planetmbit/KiCAD_LoadSW_OCP_Circuit_v1_2/README.md

# KiCAD_LoadSW_OCP_Circuit_v1_2
This is Over Current Protection & Load Switch(w/ Current Sense) Circuit's KiCAD Repository (This belongs to the author and The Ryman Sat Project.)
