planetmbit/KiCAD_LoadSW_OCP_Circuit_v1_2/FusionPCB_Files/BOM_r02.xlsx

Designator | MPN/Seeed SKU | Qty | Link
C1 C2 C3 C4 C5 C6 C7 C8 C9 C10 C11 C12 C13 C14 C15 C16 C17 C18 C19 C20 C21 C22 C23 C24 C25 C26 | VJ0603Y104KXXAC | 26 | https://www.digikey.com/en/products/detail/vishay-vitramon/VJ0603Y104KXXAC/2345170
Q1 Q4 Q7 Q10 Q13 Q16 Q19 Q22 | SISS23DN-T1-GE3 | 8 | http://www.vishay.com/docs/62852/siss23dn.pdf
R24 R35 R46 R57 R72 R83 | RK73H1JTTD1004F | 6 | https://www.digikey.jp/product-detail/ja/koa-speer-electronics-inc/RK73H1JTTD1004F/2019-RK73H1JTTD1004FCT-ND/9846893
R25 R28 R29 R36 R39 R40 R47 R50 R51 R58 R61 R62 R65 R66 R73 R76 R77 R84 R87 R88 R91 R92 | RK73H1JTTD1002F | 22 | https://www.digikey.jp/product-detail/ja/koa-speer-electronics-inc/RK73H1JTTD1002F/2019-RK73H1JTTD1002FTR-ND/9844954
R26 R37 R48 R59 R74 R85 R118 R119 R120 R121 R123 | RK73B1JTTD102J | 11 | https://www.digikey.jp/product-detail/ja/koa-speer-electronics-inc/RK73B1JTTD102J/2019-RK73B1JTTD102JTR-ND/9844698
R1 R2 R3 R4 R5 R6 R7 R8 R9 R10 R11 R12 R13 R14 R15 R16 R17 R18 R19 R94 R95 R97 R98 R100 R101 R103 R104 R106 R107 R109 R110 R112 R113 R115 R116 | RK73Z1JTTD | 35 | https://www.digikey.jp/product-detail/ja/koa-speer-electronics-inc/RK73Z1JTTD/2019-RK73Z1JTTDTR-ND/9845478
Rh1 Rh2 Rh3 Rh4 Rh5 Rh6 R21 R27 R30 R32 R38 R41 R43 R49 R52 R54 R60 R63 R64 R67 R69 R75 R78 R80 R86 R89 R90 R93 | RK73B1JTTD104J | 28 | https://www.digikey.jp/product-detail/ja/koa-speer-electronics-inc/RK73B1JTTD104J/2019-RK73B1JTTD104JTR-ND/9844700
