planetmbit/KiCAD_LoadSW_OCP_Circuit_v1_2/Assembly/AssemblyDrawing.pdf

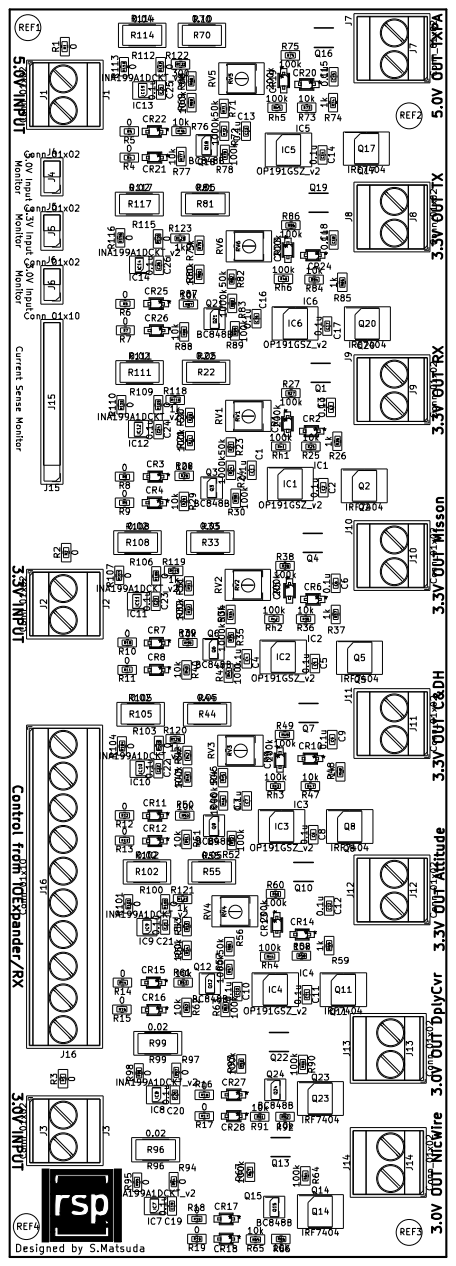
[picture p18: page 1]
