planetmbit/KiCAD_LoadSW_OCP_Circuit_v1_2/(commit log)

2020-12-06 Changed Design plan(Module Design)
    [rsp02_LoadSW_OCP_Circuit_v1_2.sch, rsp02_module_CS.sch, rsp02_module_LoadSW_OCP_3_3V.sch, rsp02_module_LoadSW_OCP_5_0V.sch, rsp02_module_LoadSW_noOCP.sch]
2020-12-07 Update Design
    [rsp02_LoadSW_OCP_Circuit_v1_2.sch, rsp02_module_CS.sch, rsp02_module_CS_3_3V.sch, rsp02_module_CS_5_0V.sch, rsp02_module_LoadSW_OCP_3_3V.sch, rsp02_module_LoadSW_OCP_5_0V.sch, rsp02_module_LoadSW_noOCP.sch]
2020-12-08 Update PCB
    [rsp02_LoadSW_OCP_Circuit_v1_2.csv, rsp02_LoadSW_OCP_Circuit_v1_2.kicad_pcb, rsp02_LoadSW_OCP_Circuit_v1_2.sch, rsp02_module_CS_3_3V.sch, rsp02_module_CS_5_0V.sch, rsp02_module_LoadSW_OCP_3_3V.sch, rsp02_module_LoadSW_OCP_5_0V.sch, rsp02_module_LoadSW_noOCP.sch]
2020-12-09 PCB Update
    [rsp02_LoadSW_OCP_Circuit_v1_2.csv, rsp02_LoadSW_OCP_Circuit_v1_2.kicad_pcb, rsp02_LoadSW_OCP_Circuit_v1_2.sch, rsp02_LoadSW_OCP_Circuit_v1_2_bom2csv.csv, rsp02_LoadSW_OCP_Circuit_v1_2_bom2grouped.csv, rsp02_module_LoadSW_OCP_3_3V.sch, rsp02_module_LoadSW_OCP_5_0V.sch, rsp02_module_LoadSW_noOCP.sch]
2020-12-12 PCB Design Finished
    [rsp02_LoadSW_OCP_Circuit_v1_2.kicad_pcb, rsp02_LoadSW_OCP_Circuit_v1_2.sch, rsp02_module_CS_3_3V.sch, rsp02_module_LoadSW_noOCP.sch]
2020-12-13 before gerber output
    [rsp02_LoadSW_OCP_Circuit_v1_2.kicad_pcb]
2020-12-13 PCB reUpdate
    [BOM.xlsx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]
2020-12-13 PCB Manufacturing Final Version
    [BOM.xlsx, BOM_r02.xlsx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]
